Mostoples/algora/output/concept/concept_wall.png

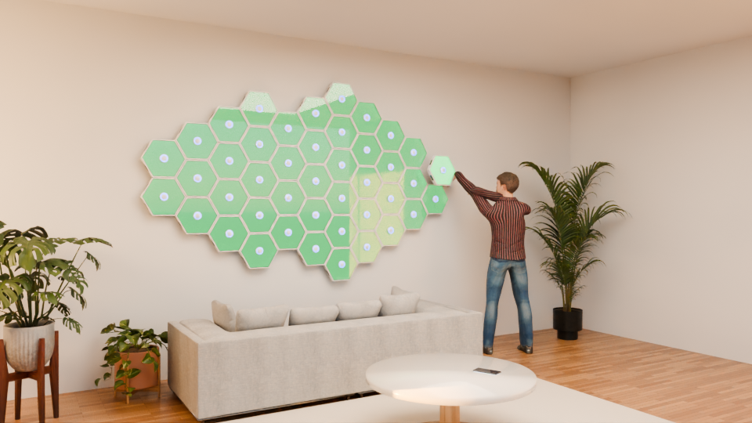
output/concept/concept_wall.png
