Mostoples/algora/output/paper/fig_assembled.jpg

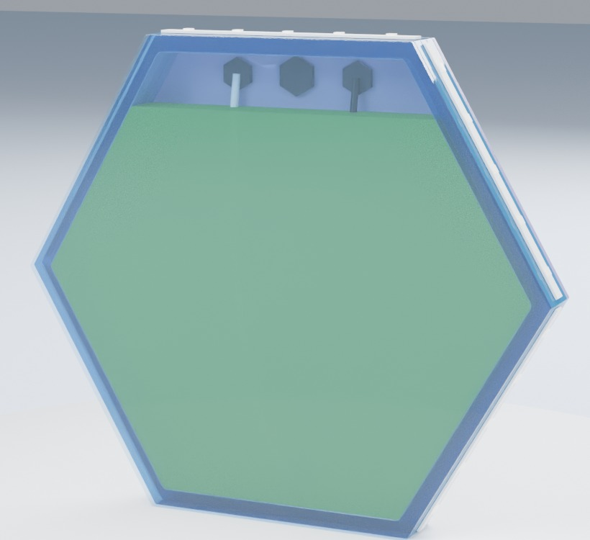
output/paper/fig_assembled.jpg
