Mostoples/algora/output/dokumen/Algora_Gambar_Teknik_Versi_SMP.pdf

# Kenalan: hexagon Algora dibuat dari 5 lapis akrilik

Seperti roti lapis: lembar - cincin - cincin - cincin - lembar

1 / 7

Algora - gambar teknik versi siswa

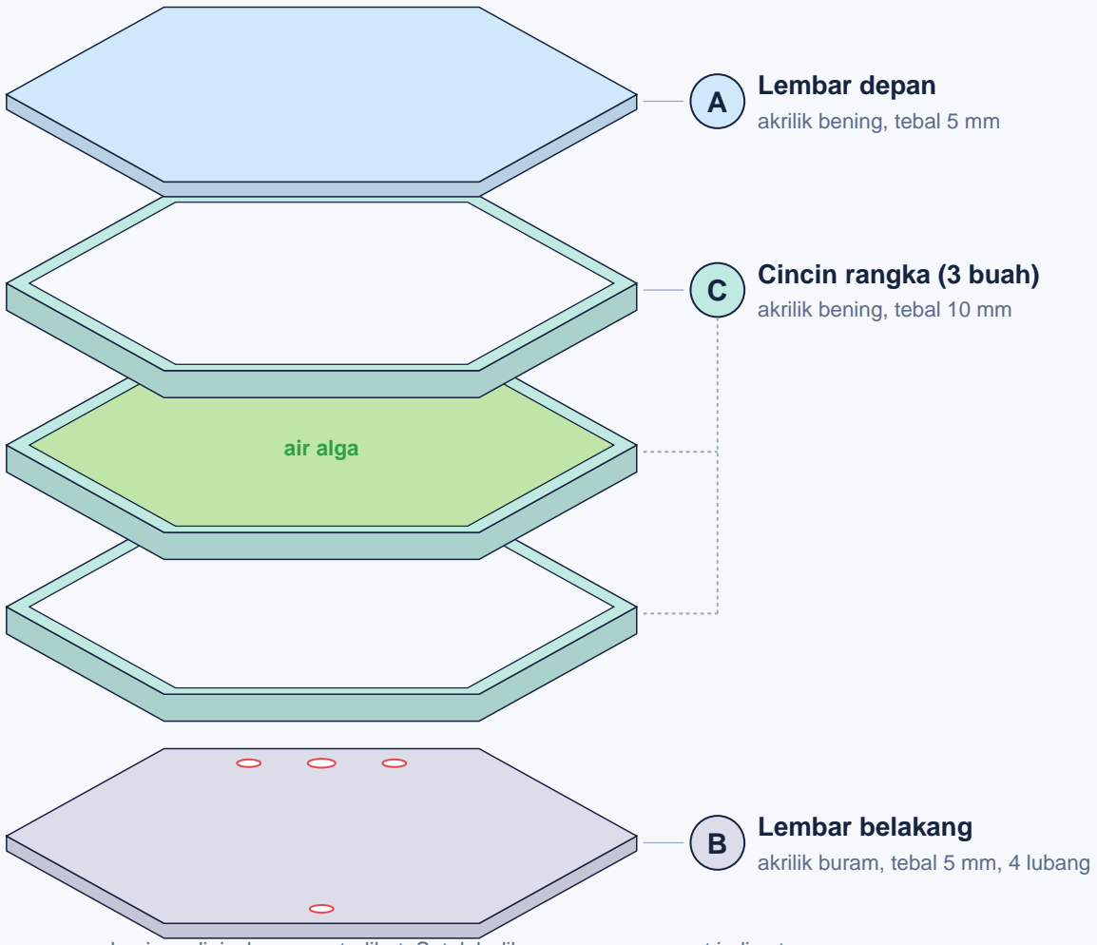
[picture p17: figure]
Lembar depan; akrilik bening, tebal 5 mm; Cincin rangka (3 buah); akrilik bening, tebal 10 mm; Lembar belakang; akrilik buram, tebal 5 mm, 4 lubang; air alga

Semua angka dalam milimeter (mm). 10 mm = 1 cm. Gambar diperkecil; angka di garis ukur adalah ukuran ASLI.

Lapisan dipisah supaya terlihat. Setelah dilem, semuanya rapat jadi satu.

## Angka penting

300 mm

lebar dari sisi datar ke sisi datar kira-kira sepanjang penggaris 30 cm

# 40 mm

tebal setelah dirakit
5 + 10 + 10 + 10 + 5

# 1,7 liter

air alga di dalamnya
ruang air setebal 30 mm

# 5 potong

bagian yang dipotong CNC
1 depan, 3 cincin, 1 belakang

# Cara membaca gambar teknik

Pelajari 6 tanda ini dulu, nanti semua halaman jadi mudah dibaca

2 / 7

Algora - gambar teknik versi siswa

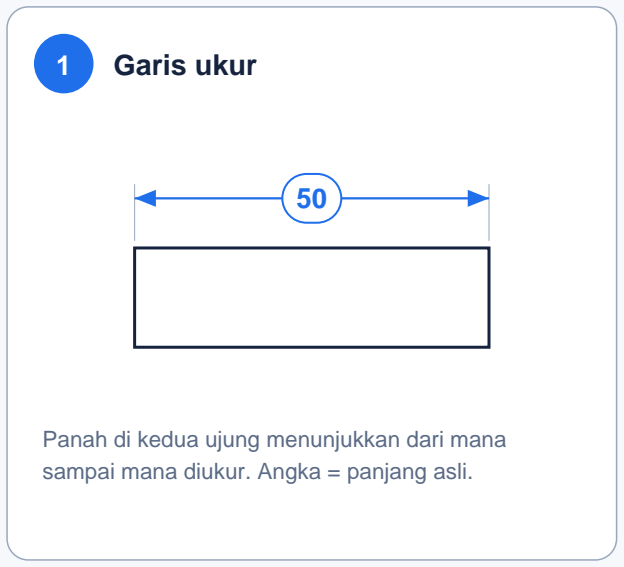
[picture p18: figure]
1 Garis ukur
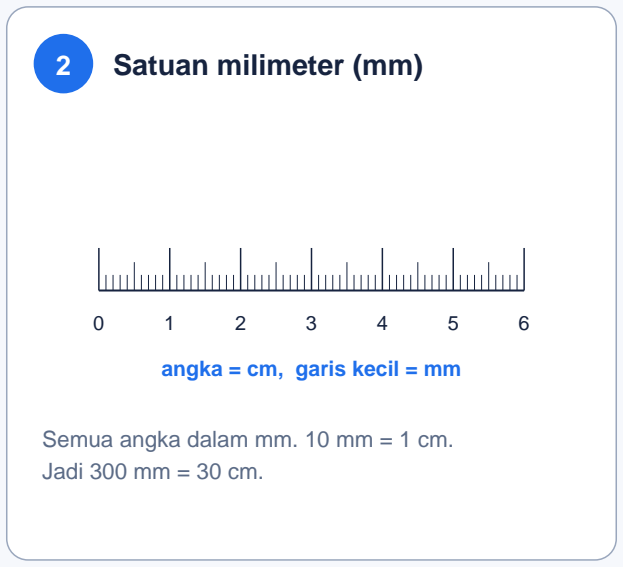
[picture p19: figure]
2 Satuan milimeter (mm); Semua angka dalam mm. 10 mm = 1 cm. Jadi 300 mm = 30 cm.; angka = cm, garis kecil = mm

Panah di kedua ujung menunjukkan dari mana sampai mana diukur. Angka = panjang asli.

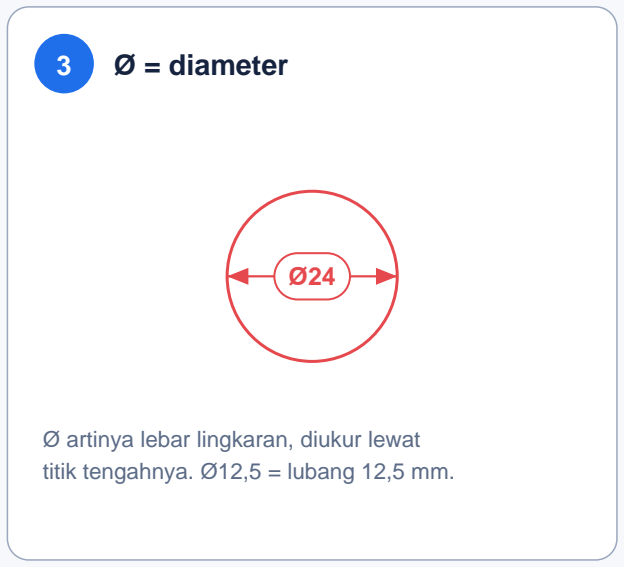
[picture p20: figure]
3 Ø = diameter; Ø artinya lebar lingkaran, diukur lewat

titik tengahnya. Ø12,5 = lubang 12,5 mm.

### 4 Garis titik-strip = garis tengah

Garis ini membelah benda tepat di tengah. Ukuran lubang diukur dari garis ini.

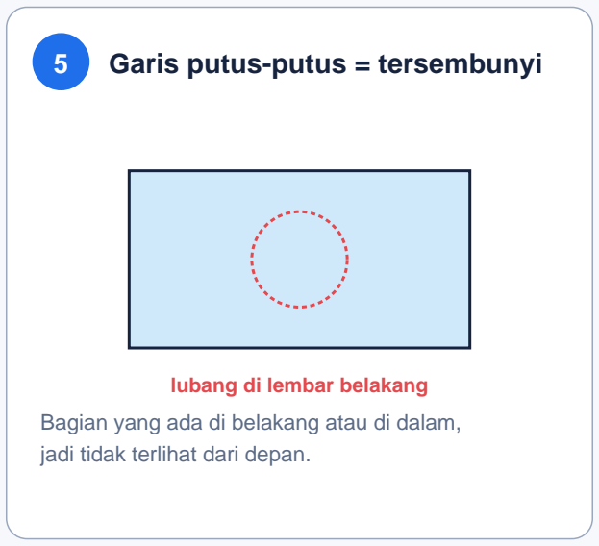
[picture p21: figure]
5 Garis putus-putus = tersembunyi; jadi tidak terlihat dari depan.; lubang di lembar belakang

Bagian yang ada di belakang atau di dalam,

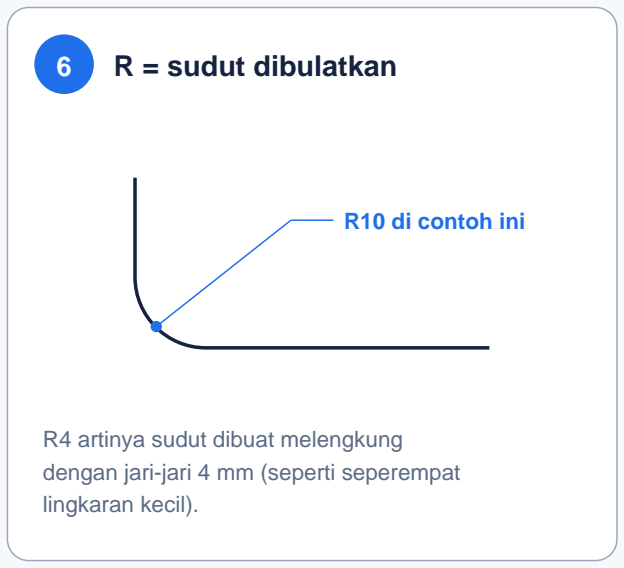
[picture p22: figure]
6 R = sudut dibulatkan; R4 artinya sudut dibuat melengkung; lingkaran kecil).; R10 di contoh ini

dengan jari-jari 4 mm (seperti seperempat

# Part A - Lembar depan

Hexagon utuh dari akrilik bening. Ini sisi yang menghadap orang.

3 / 7

Algora - gambar teknik versi siswa

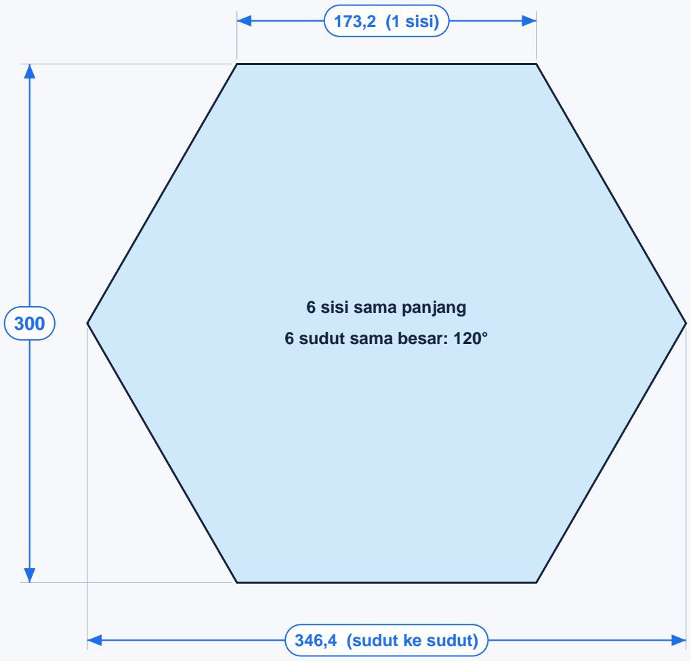
[picture p23: figure]
346,4 (sudut ke sudut); 173,2 (1 sisi); 6 sisi sama panjang; 6 sudut sama besar: 120°

Skala kira-kira 1 : 3 (gambar diperkecil). Pakai angka di garis ukur, jangan mengukur gambar.

## A Lembar depan

Bahan | akrilik bening
Tebal | 5 mm
Jumlah | 1 buah
Lubang | tidak ada

### Cek setelah dipotong:

Sisi datar ke sisi datar = 300 mm Sudut ke sudut = 346,4 mm
Tiap sisi = 173,2 mm
Tidak ada retak atau goresan dalam Kertas pelindung masih menempel

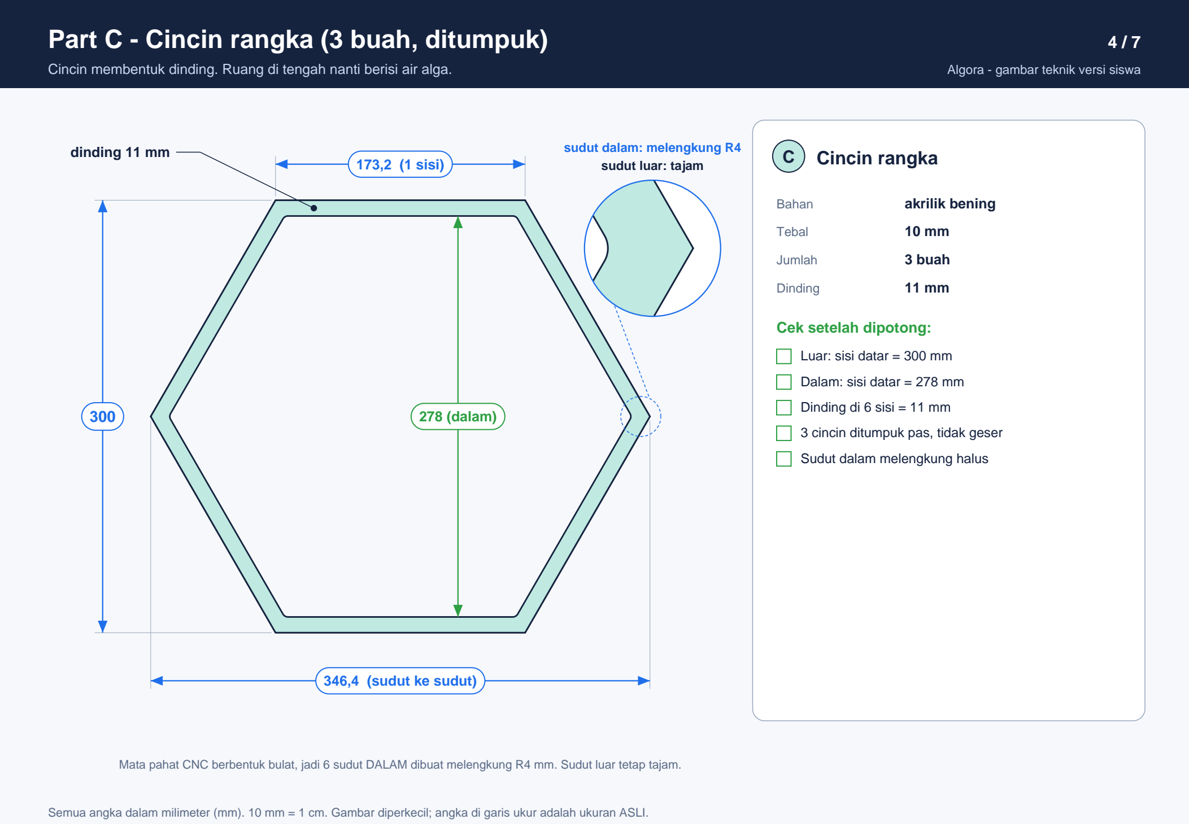
[picture p24: figure]
Algora - gambar teknik versi siswa; 346,4 (sudut ke sudut); 173,2 (1 sisi); 278 (dalam); dinding 11 mm; sudut dalam: melengkung R4; sudut luar: tajam; C Cincin rangka; Bahan; akrilik bening; Tebal; Jumlah; 3 buah; Dinding; Cek setelah dipotong:; Luar: sisi datar = 300 mm; Dalam: sisi datar = 278 mm; Dinding di 6 sisi = 11 mm; 3 cincin ditumpuk pas, tidak geser; Sudut dalam melengkung halus

# Part C - Cincin rangka (3 buah, ditumpuk)

Cincin membentuk dinding. Ruang di tengah nanti berisi air alga.

Mata pahat CNC berbentuk bulat, jadi 6 sudut DALAM dibuat melengkung R4 mm. Sudut luar tetap tajam.

# Part B - Lembar belakang dan 4 lubang

Akrilik buram. Lubang P1-P4 untuk selang, kabel, dan menguras air.

5 / 7

Algora - gambar teknik versi siswa

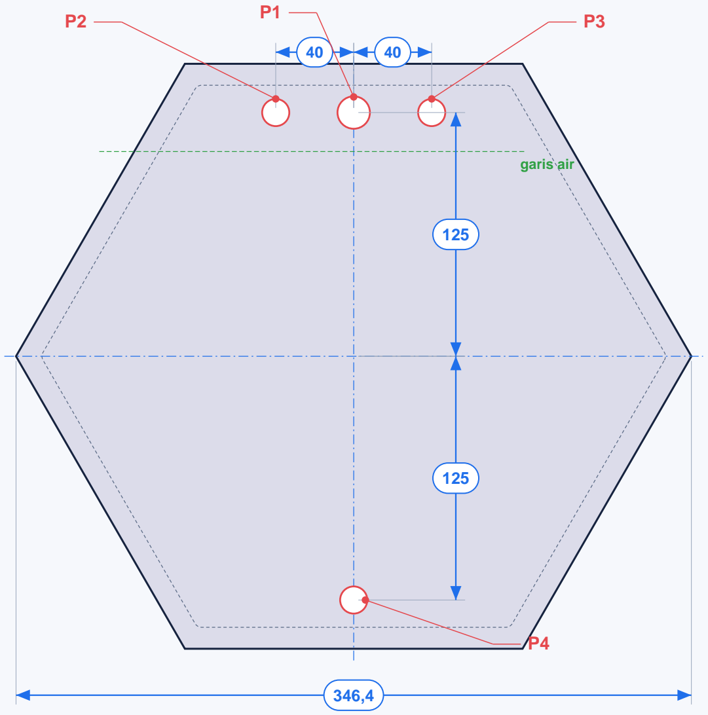
[picture p25: figure]
garis air

Ukuran lubang diukur dari GARIS TENGAH (titik-strip biru), bukan dari tepi.

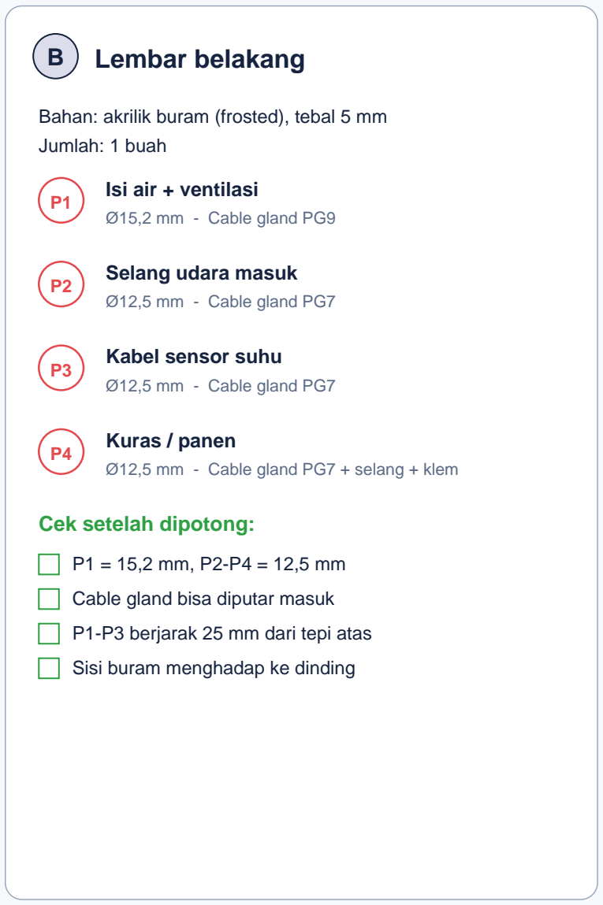
[picture p26: figure]
B Lembar belakang; Jumlah: 1 buah; Isi air + ventilasi; Ø15,2 mm - Cable gland PG9; Selang udara masuk; Ø12,5 mm - Cable gland PG7; Kabel sensor suhu; Kuras / panen; Cek setelah dipotong:; Cable gland bisa diputar masuk; P1-P3 berjarak 25 mm dari tepi atas; Sisi buram menghadap ke dinding

Bahan: akrilik buram (frosted), tebal 5 mm

Ø12,5 mm - Cable gland PG7 + selang + klem

# Susunan lapisan (dilihat dari samping)

6 / 7

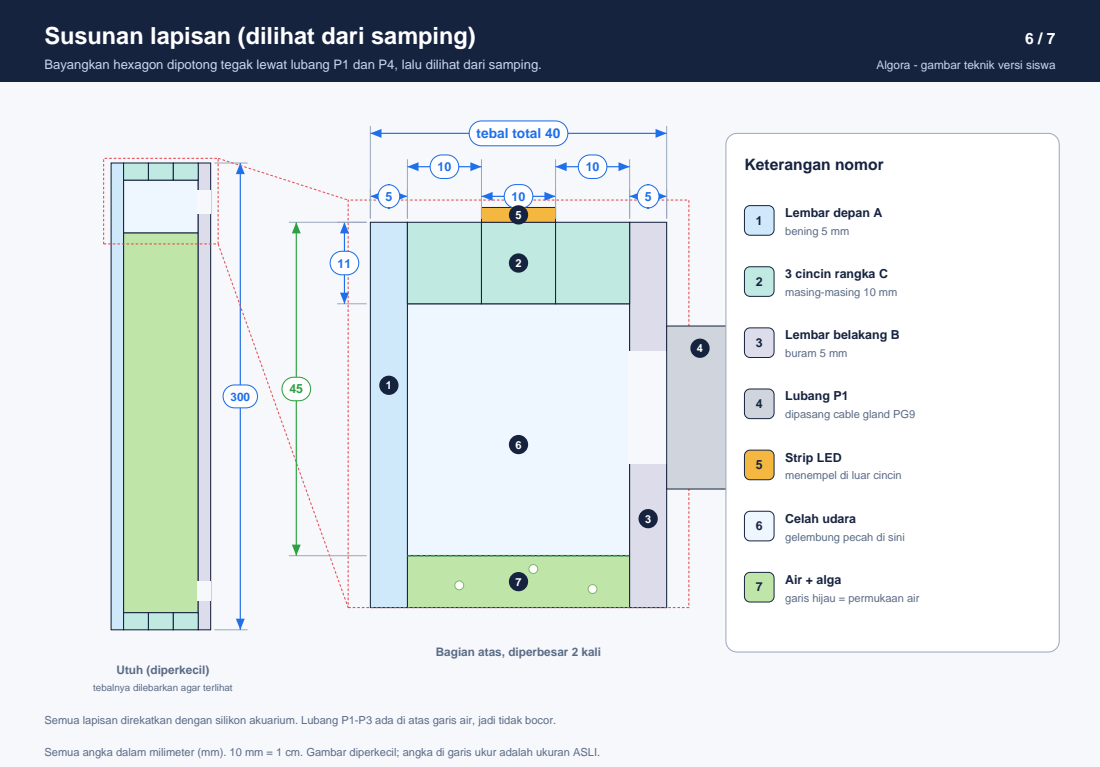
[picture p27: page 6]
tebal total 40; Keterangan nomor; Lembar depan A bening 5 mm; Lembar belakang B buram 5 mm 4; Lubang P1 dipasang cable gland PG9

Bayangkan hexagon dipotong tegak lewat lubang P1 dan P4, lalu dilihat dari samping.

Algora - gambar teknik versi siswa

3 cincin rangka C
masing-masing 10 mm

Strip LED
menempel di luar cincin

Celah udara
gelembung pecah di sini

Air + alga
garis hijau = permukaan air

Bagian atas, diperbesar 2 kali

Utuh (diperkecil)
tebalnya dilebarkan agar terlihat

Semua lapisan direkatkan dengan silikon akuarium. Lubang P1-P3 ada di atas garis air, jadi tidak bocor.

# Merakit dan memeriksa

Ikuti urutan ini. Kerjakan bersama guru, dan tunggu silikon kering sebelum lanjut.

7 / 7

Algora - gambar teknik versi siswa

## Tabel cek ukuran (isi setelah dipotong)

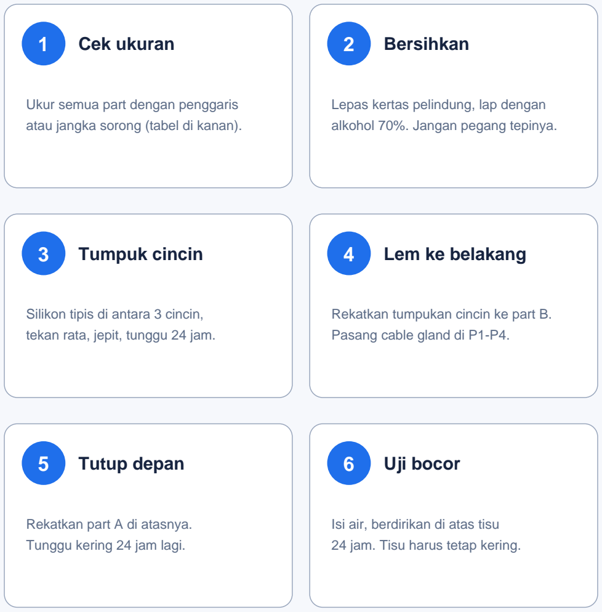
[picture p28: figure]
1 Cek ukuran; Ukur semua part dengan penggaris atau jangka sorong (tabel di kanan).; 2 Bersihkan; Lepas kertas pelindung, lap dengan alkohol 70%. Jangan pegang tepinya.; 3 Tumpuk cincin; Silikon tipis di antara 3 cincin, tekan rata, jepit, tunggu 24 jam.; 4 Lem ke belakang; Rekatkan tumpukan cincin ke part B. Pasang cable gland di P1-P4.; 5 Tutup depan; Rekatkan part A di atasnya. Tunggu kering 24 jam lagi.; 6 Uji bocor; Isi air, berdirikan di atas tisu 24 jam. Tisu harus tetap kering.

Part | Yang diukur | Target (mm) Hasil ukur | OK?
A | Sisi datar ke sisi datar | 300
A | Sudut ke sudut | 346,4
C1 | Luar, sisi datar | 300
C1 | Dalam, sisi datar | 278
C2 | Luar, sisi datar | 300
C2 | Dalam, sisi datar | 278
C3 | Luar, sisi datar | 300
C3 | Dalam, sisi datar | 278
B | Sisi datar ke sisi datar | 300
B | Lubang P1 | Ø15,2
B | Lubang P2 / P3 / P4 | Ø12,5
B | P1 ke tepi atas | 25
Rakit | Tebal total | 40

Keselamatan: silikon dan lem dipakai di ruang terbuka. Jangan pegang tepi akrilik yang tajam. Boleh selisih sampai +/- 0,5 mm. Jika lebih, beri tahu operator CNC sebelum dilem.
