Mostoples/algora/app/assets/img/hero_cluster.png

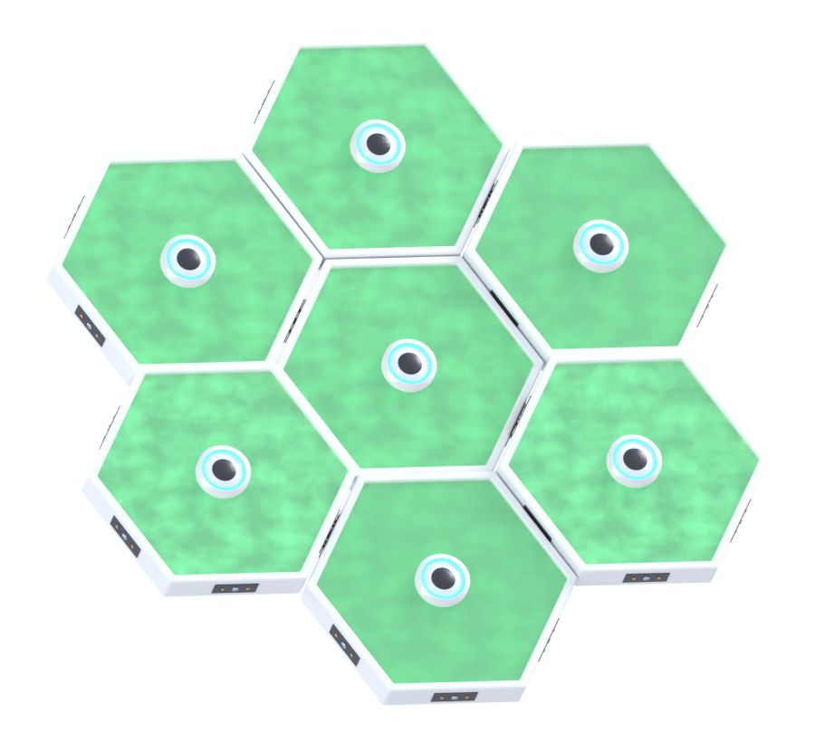
app/assets/img/hero_cluster.png
