Mostoples/algora/app/assets/img/ic_ai.png

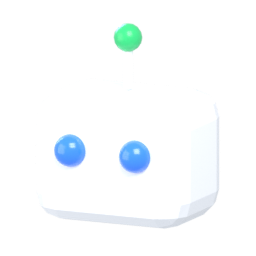
app/assets/img/ic_ai.png
