Mostoples/algora/app/assets/img/ic_bolt.png

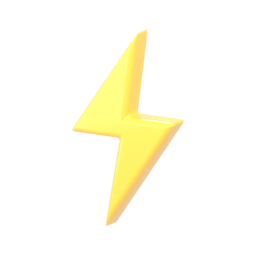
app/assets/img/ic_bolt.png
