Mostoples/algora/app/assets/img/ic_co2.png

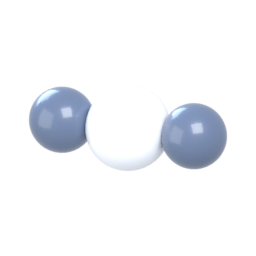
app/assets/img/ic_co2.png
