Mostoples/algora/app/assets/img/ic_drop.png

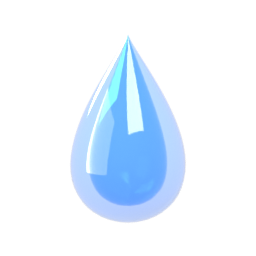
app/assets/img/ic_drop.png
