Mostoples/algora/app/assets/img/ic_leaf.png

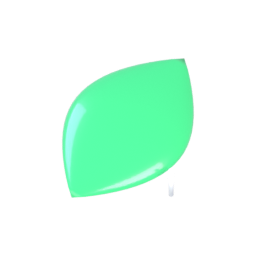
app/assets/img/ic_leaf.png
