Mostoples/algora/app/assets/img/ic_ph.png

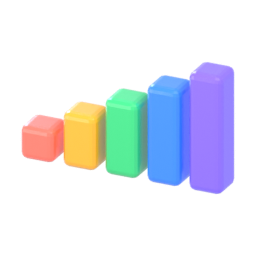
app/assets/img/ic_ph.png
