Mostoples/algora/app/assets/img/ic_temp.png

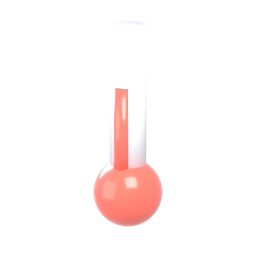
app/assets/img/ic_temp.png
