Mostoples/algora/app/assets/img/m_floor.png

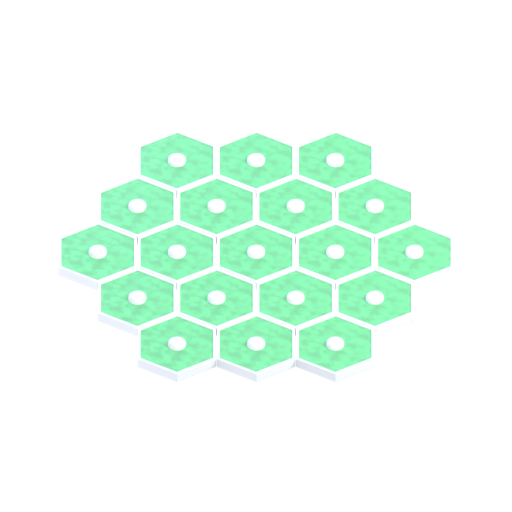
app/assets/img/m_floor.png
