Mostoples/algora/app/assets/img/m_lamp.png

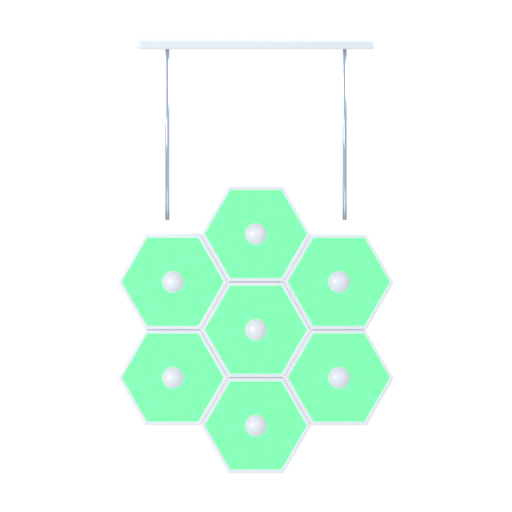
app/assets/img/m_lamp.png
