Mostoples/algora/app/assets/img/m_roof.png

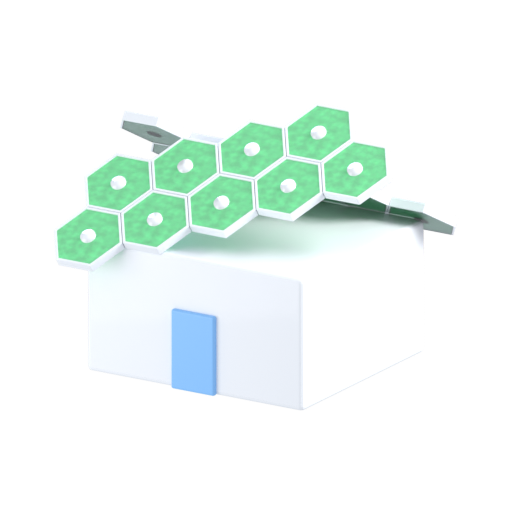
app/assets/img/m_roof.png
