Mostoples/algora/app/assets/img/m_wall.png

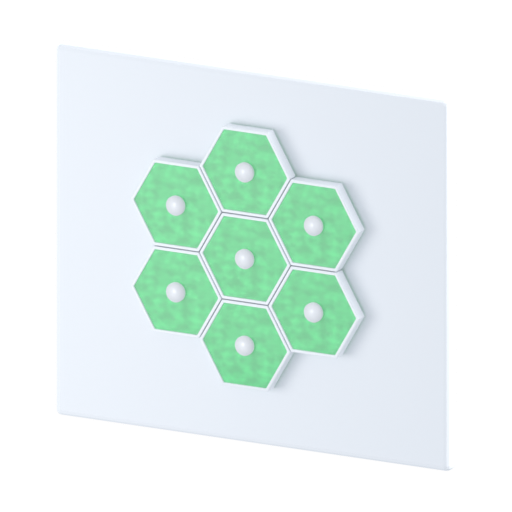
app/assets/img/m_wall.png
