Mostoples/algora/app/assets/img/module.png

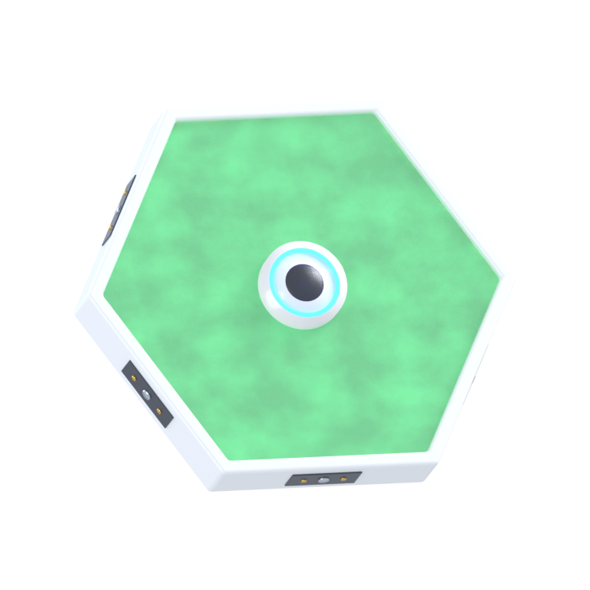
app/assets/img/module.png
