Mostoples/algora/output/concept/ALGORA_concept_board.png

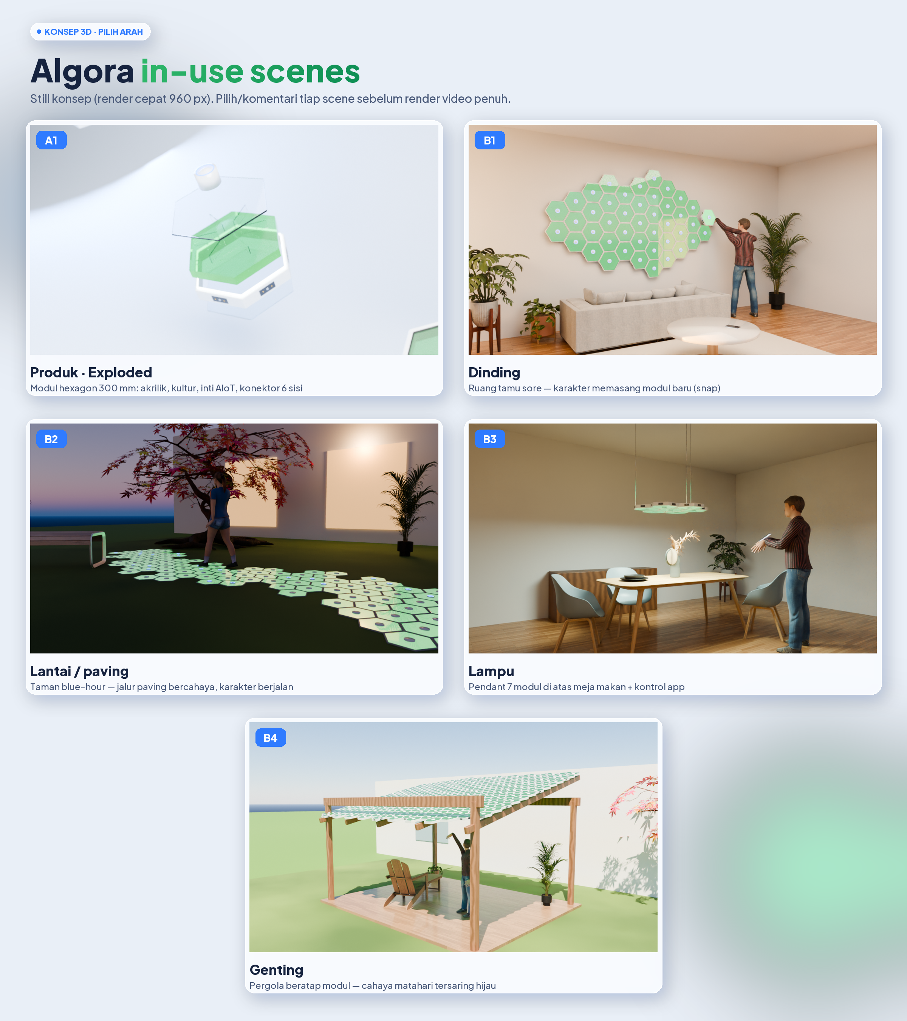
output/concept/ALGORA_concept_board.png
