Mostoples/algora/output/concept/concept_floor.png

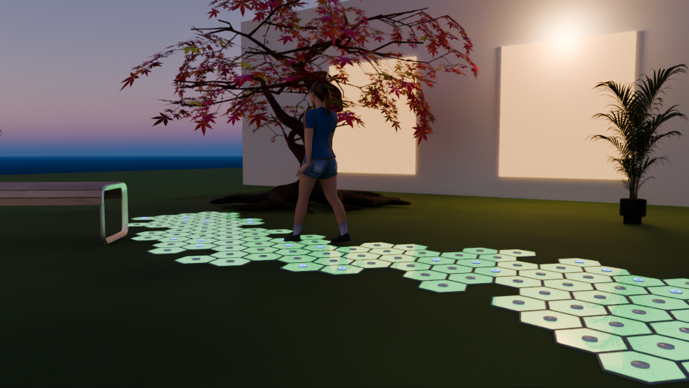
output/concept/concept_floor.png
