Mostoples/algora/output/concept/concept_hero.png

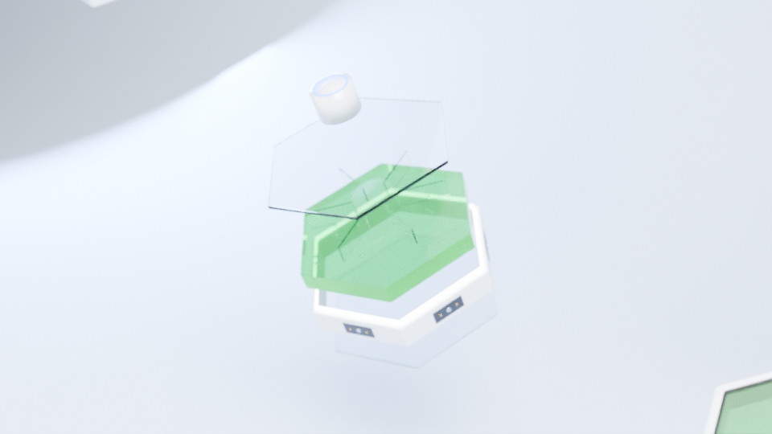
output/concept/concept_hero.png
