Mostoples/algora/output/concept/concept_lamp.png

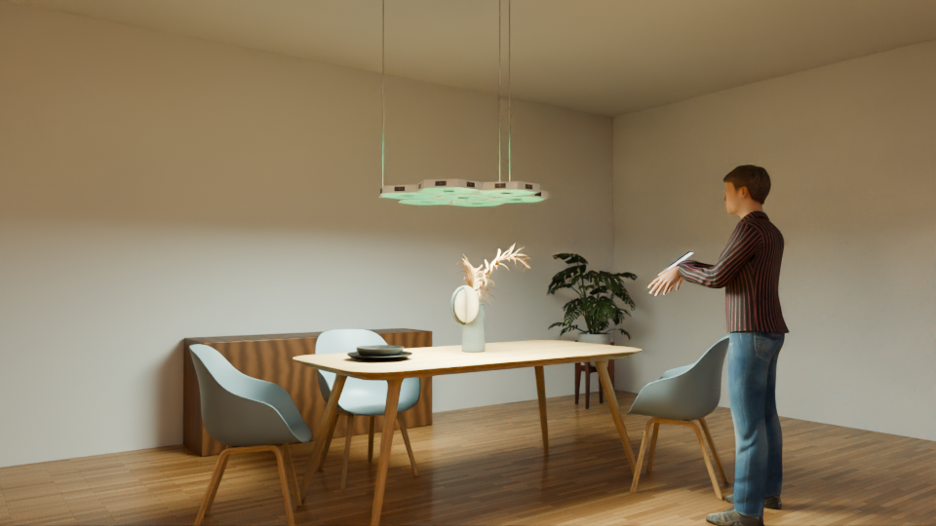
output/concept/concept_lamp.png
