Mostoples/algora/output/concept/concept_roof.png

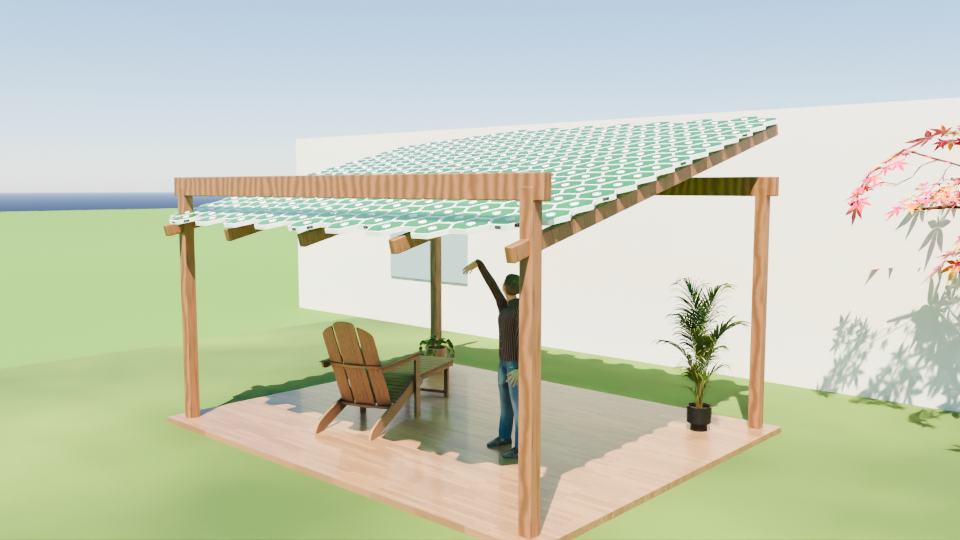
output/concept/concept_roof.png
