Mostoples/algora/output/paper/fig_architecture.png

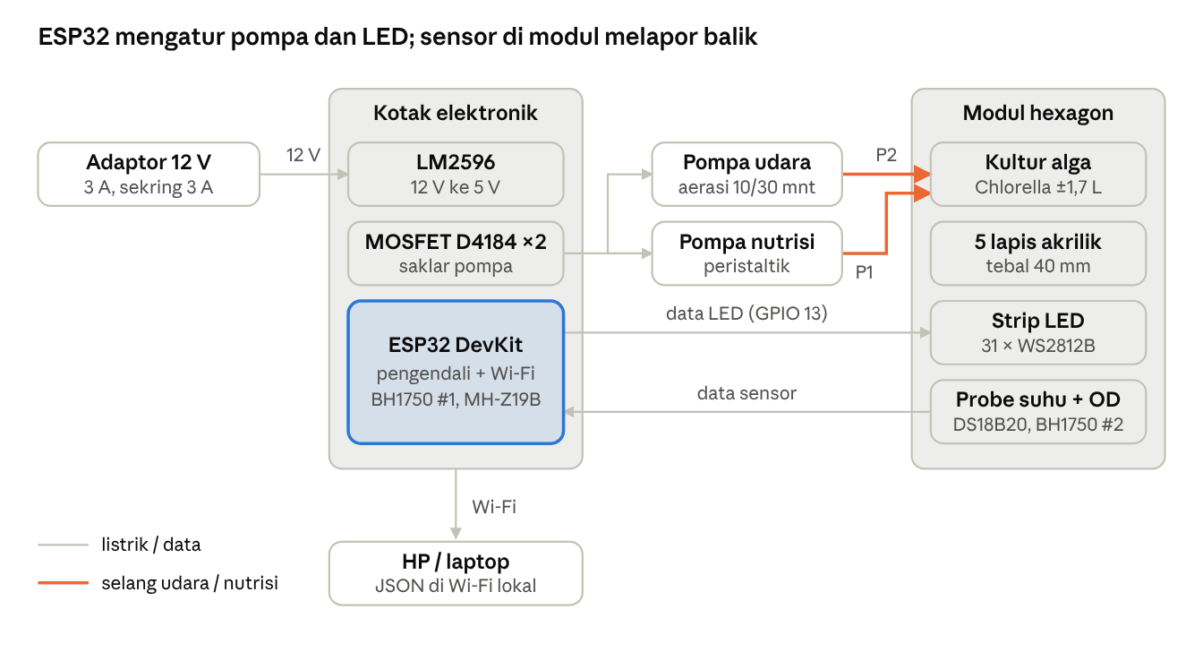
output/paper/fig_architecture.png
