Mostoples/algora/output/paper/fig_drawing.png

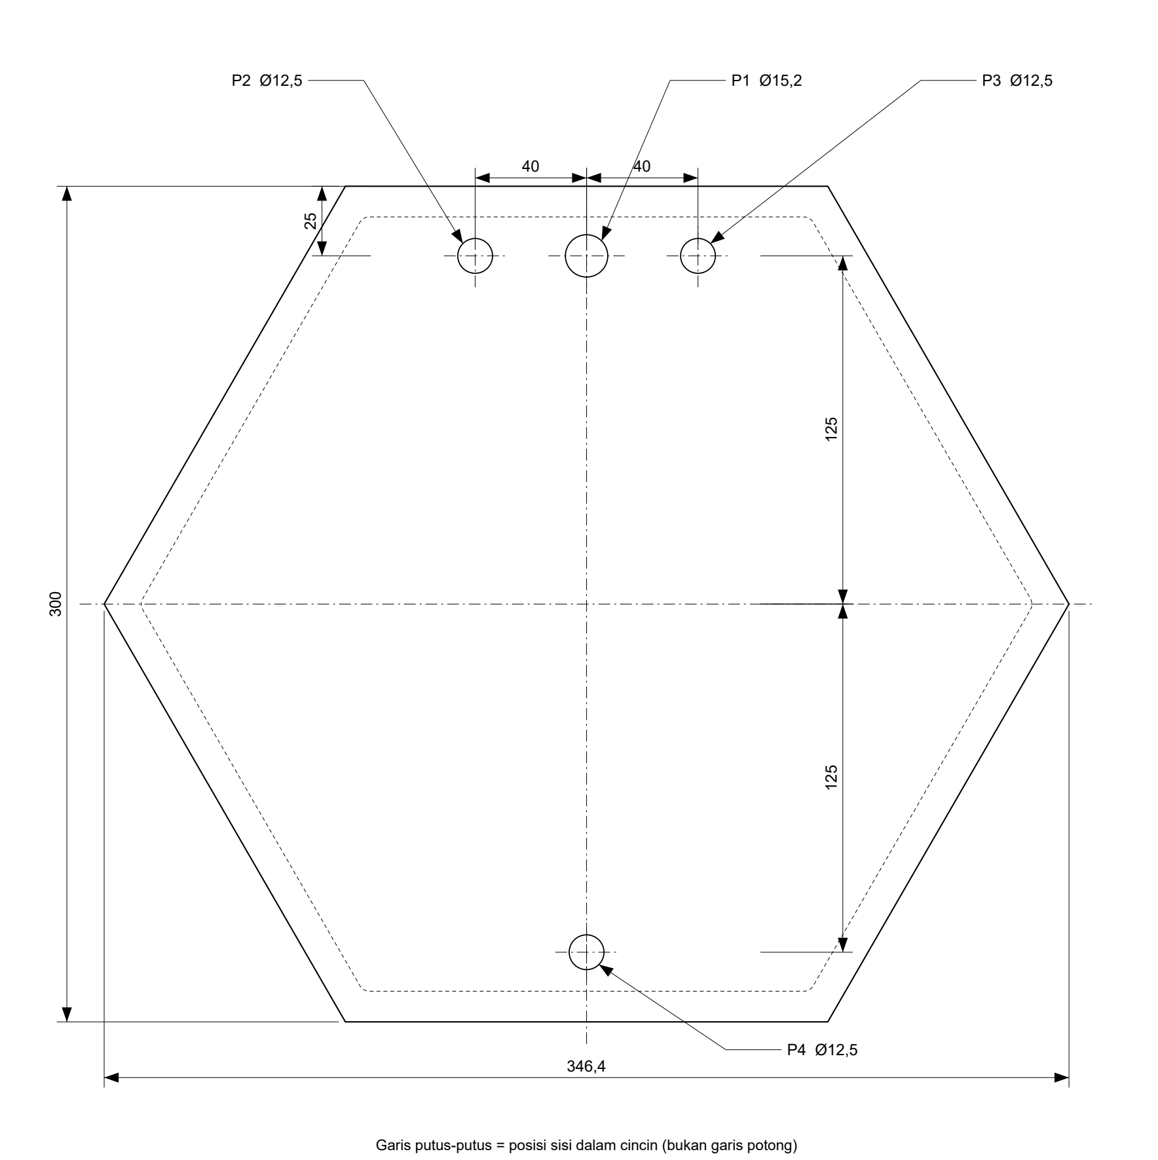
output/paper/fig_drawing.png
