Mostoples/algora/output/cnc/Algora_A_Lembar_depan_5mm_1buah.dxf

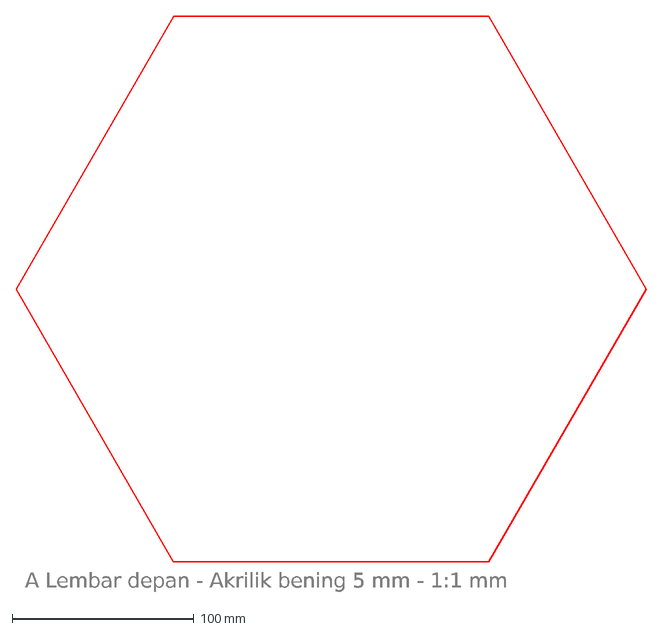
[picture p57: CAD file, 2026-11-12]
output/cnc/Algora_A_Lembar_depan_5mm_1buah.dxf
A Lembar depan - Akrilik bening 5 mm - 1:1 mm
