Mostoples/algora/output/paper/Algora_Detail_Design.dxf

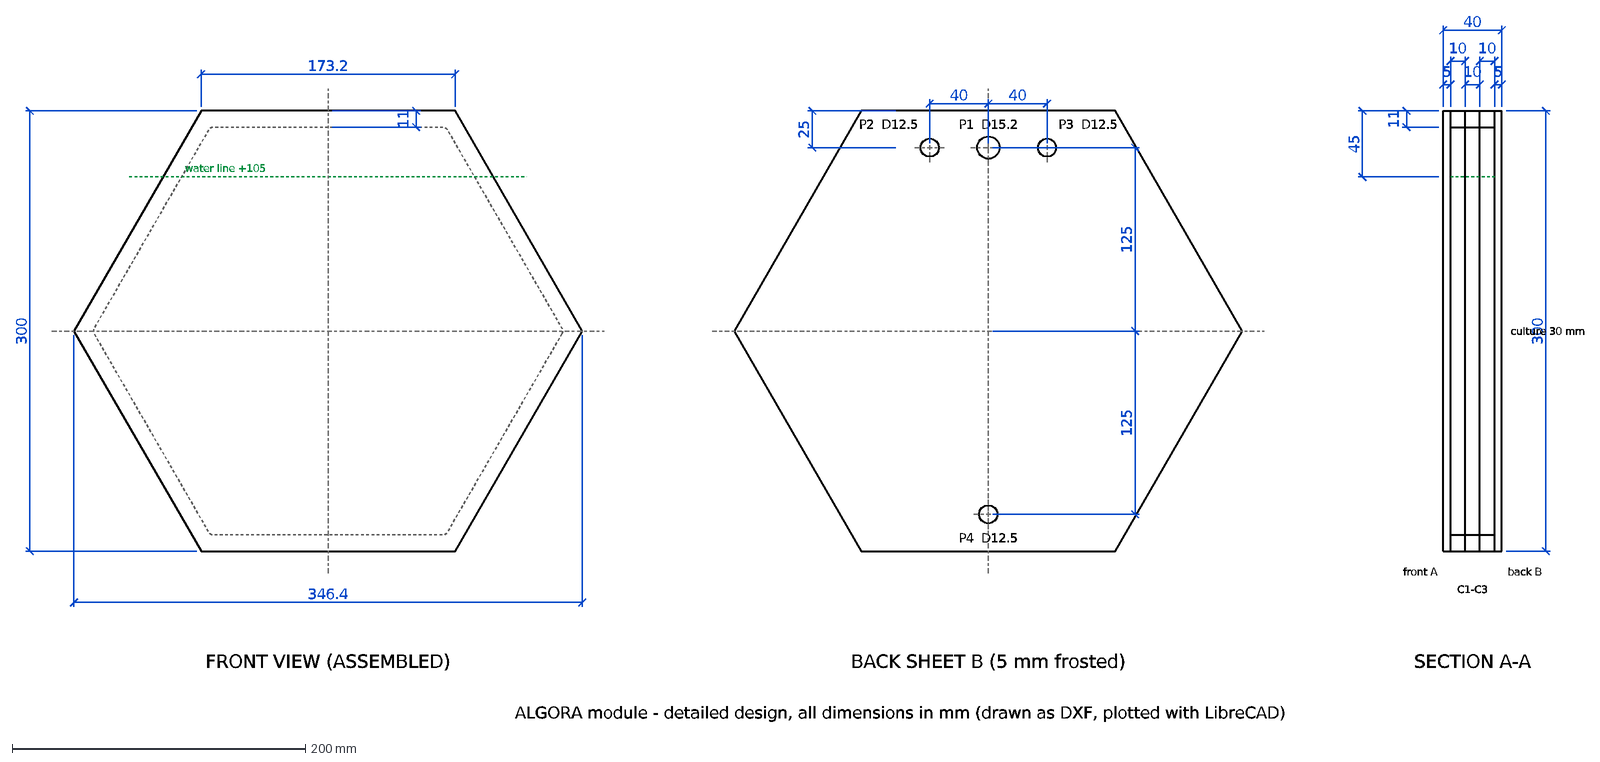
[picture p58: CAD file, 2026-11-12]
output/paper/Algora_Detail_Design.dxf
346.4
300
173.2
11
water line +105
FRONT VIEW (ASSEMBLED)
P1 D15.2
P2 D12.5
P3 D12.5
P4 D12.5
40
125
25
BACK SHEET B (5 mm frosted)
5
10
45
front A
back B
C1-C3
culture 30 mm
SECTION A-A
ALGORA module - detailed design, all dimensions in mm (drawn as DXF, plotted with LibreCAD)
