Mostoples/algora/output/cnc/Algora_C_Cincin_rangka_10mm_1buah.dxf

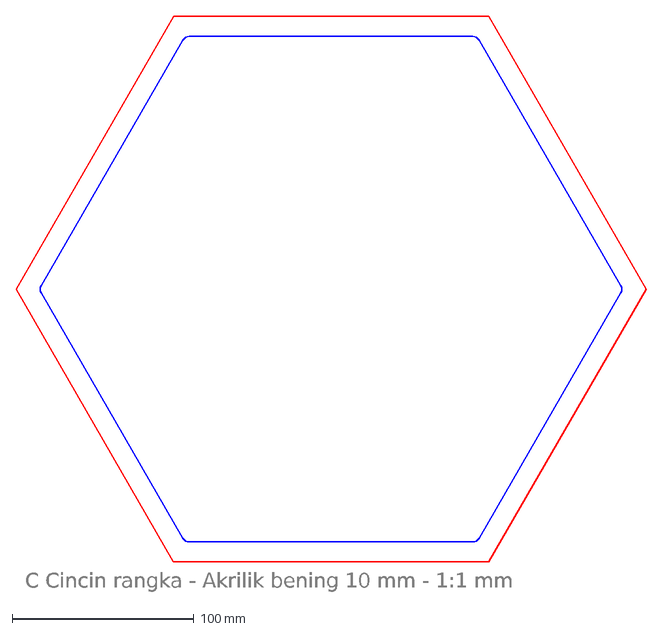
[picture p59: CAD file, 2026-11-12]
output/cnc/Algora_C_Cincin_rangka_10mm_1buah.dxf
C Cincin rangka - Akrilik bening 10 mm - 1:1 mm
