Mostoples/algora/output/cnc/Algora_B_Lembar_belakang_5mm_1buah.dxf

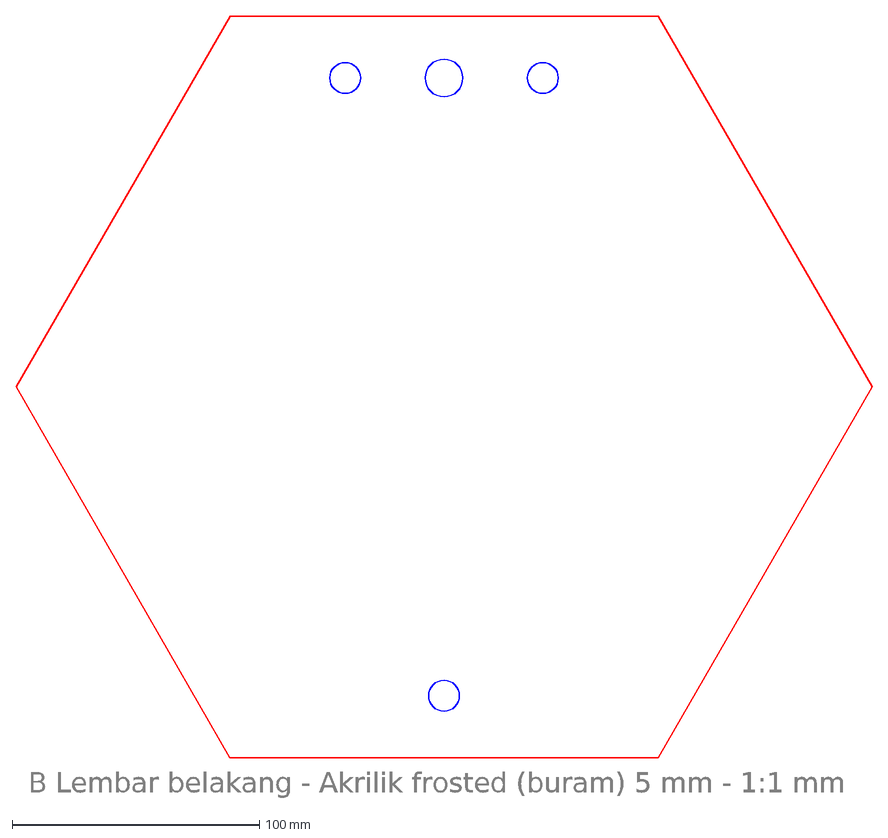
[picture p60: CAD file, 2026-11-12]
output/cnc/Algora_B_Lembar_belakang_5mm_1buah.dxf
B Lembar belakang - Akrilik frosted (buram) 5 mm - 1:1 mm
