Mostoples/algora/output/cnc/Algora_C_Cincin_rangka_10mm_3buah_nesting.dxf

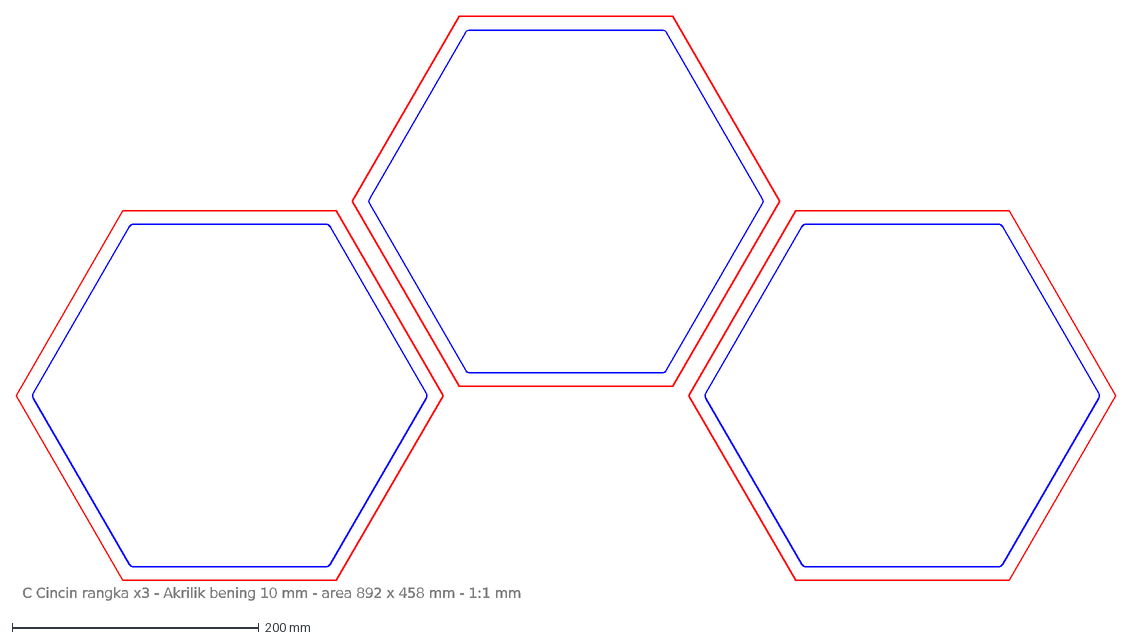
[picture p61: CAD file, 2026-11-12]
output/cnc/Algora_C_Cincin_rangka_10mm_3buah_nesting.dxf
C Cincin rangka x3 - Akrilik bening 10 mm - area 892 x 458 mm - 1:1 mm
