Mostoples/algora/output/paper/Algora_Detail_Design.pdf

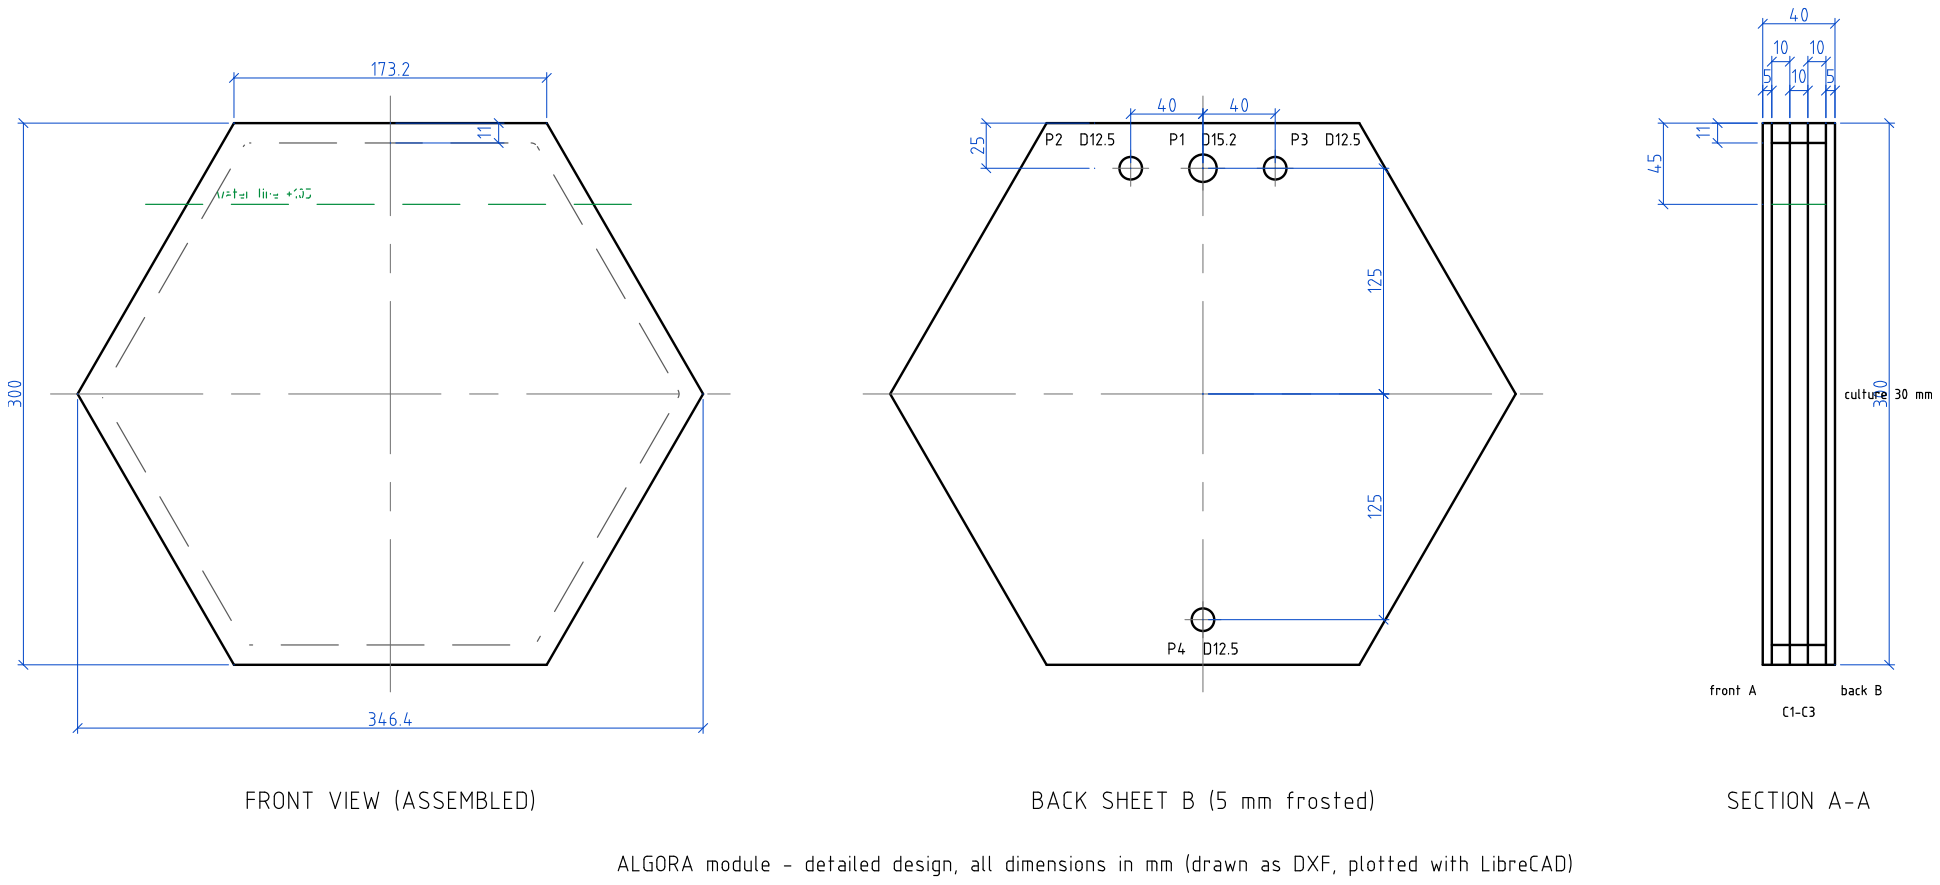
[picture p62: page 1]
