Mostoples/algora/(commit log)

2026-11-12 Algora: web app, CNC files, Blender/showreel pipeline, documents and full paper
    [Algora_A_Lembar_depan_5mm_1buah.dxf, Algora_B_Lembar_belakang_5mm_1buah.dxf, Algora_C_Cincin_rangka_10mm_1buah.dxf, Algora_C_Cincin_rangka_10mm_3buah_nesting.dxf, Algora_Detail_Design.dxf]
2026-11-12 Landing page: immersive 3D site (three.js, GSAP, Lenis) with app at /app/
2026-11-12 Landing page: light/dark theme toggle and Indonesian/English language switch
